clacktronics/5150uvc/docs/5150UVC_schematic.pdf

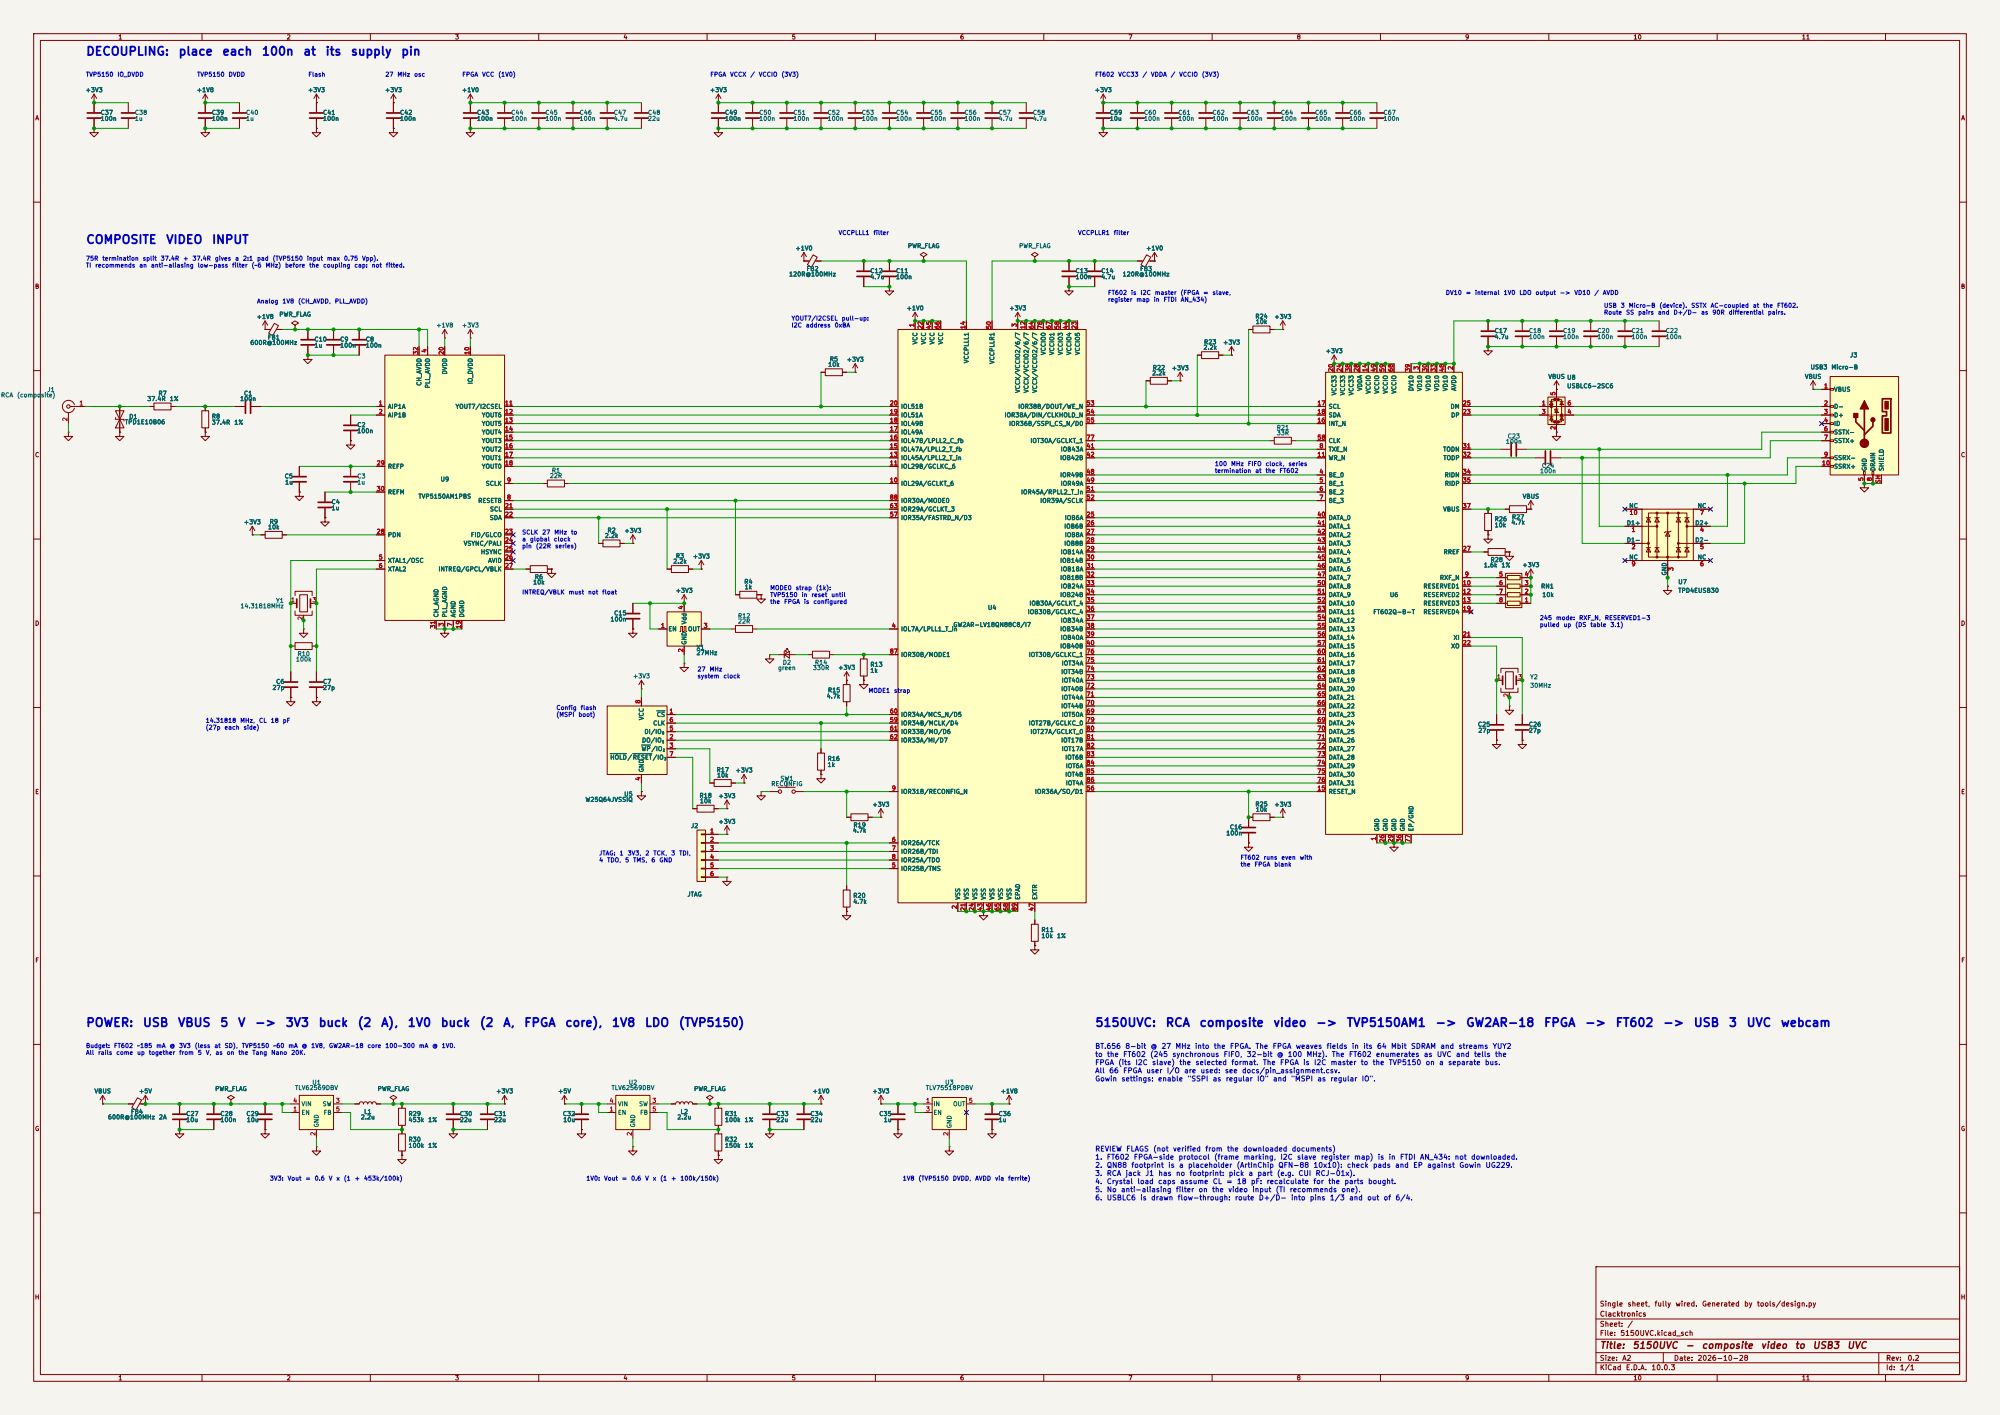
[picture p1: page 1]

75R termination split 37.4R + 37.4R gives a 2:1 pad (TVP5150 input max 0.75 Vpp). TI recommends an anti-aliasing low-pass filter (~6 MHz) before the coupling cap: not fitted. DECOUPLING: place each 100n at its supply pin

INTREQ/VBLK must not float COMPOSITE VIDEO INPUT

FT602 is I2C master (FPGA = slave,

DV10 = internal 1V0 LDO output -> VD10 / AVDD

VBUS VBUS SSRX-SSRX-SSRX+ SSRX+

termination at the FT602 | 100n R27

a global clock pin (22R series)

9 RESERVED1 9 RESERVED1 6 6 | 3 3

MODE0 strap (1k): TVP5150 in reset until the FPGA is configured

245 mode: RXF_N, RESERVED1-3
pulled up (DS table 3.1)

4 DI/IO0 5 CLK 6 HOLD/RESET/IO3 7 VCC

JTAG: 1 3V3, 2 TCK, 3 TDI, 4 TDO, 5 TMS, 6 GND

3 3 | IOR26B/TDI 7
4 4 | IOR25A/TDO 8
5 5 | IOR25B/TMS 5

the FPGA blank Budget: FT602 ~185 mA @ 3V3 (less at SD), TVP5150 ~60 mA @ 1V8, GW2AR-18 core 100-300 mA @ 1V0. All rails come up together from 5 V, as on the Tang Nano 20K. POWER: USB VBUS 5 V -> 3V3 buck (2 A), 1V0 buck (2 A, FPGA core), 1V8 LDO (TVP5150)

5150UVC: RCA composite video -> TVP5150AM1 -> GW2AR-18 FPGA -> FT602 -> USB 3 UVC webcam

BT.656 8-bit @ 27 MHz into the FPGA. The FPGA weaves fields in its 64 Mbit SDRAM and streams YUY2
to the FT602 (245 synchronous FIFO, 32-bit @ 100 MHz). The FT602 enumerates as UVC and tells the
FPGA (its I2C slave) the selected format. The FPGA is I2C master to the TVP5150 on a separate bus.
All 66 FPGA user I/O are used: see docs/pin_assignment.csv.
Gowin settings: enable "SSPI as regular IO" and "MSPI as regular IO".

REVIEW FLAGS (not verified from the downloaded documents)
1. FT602 FPGA-side protocol (frame marking, I2C slave register map) is in FTDI AN_434: not downloaded.
2. QN88 footprint is a placeholder (ArtInChip QFN-88 10x10): check pads and EP against Gowin UG229.
3. RCA jack J1 has no footprint: pick a part (e.g. CUI RCJ-01x).
4. Crystal load caps assume CL = 18 pF: recalculate for the parts bought.
5. No anti-aliasing filter on the video input (TI recommends one).
6. USBLC6 is drawn flow-through: route D+/D- into pins 1/3 and out of 6/4.

1V8 (TVP5150 DVDD, AVDD via ferrite)

Single sheet, fully wired. Generated by tools/design.py
Clacktronics
Sheet: /
File: 5150UVC.kicad_sch
Title: 5150UVC - composite video to USB3 UVC

Size: A2 | Rev: 0.2
KiCad E.D.A. 10.0.3 | Id: 1/1
