clacktronics/5150uvc/hardware/5150UVC.kicad_sch

## KiCad design hardware/5150UVC.kicad_sch (2026-11-06)

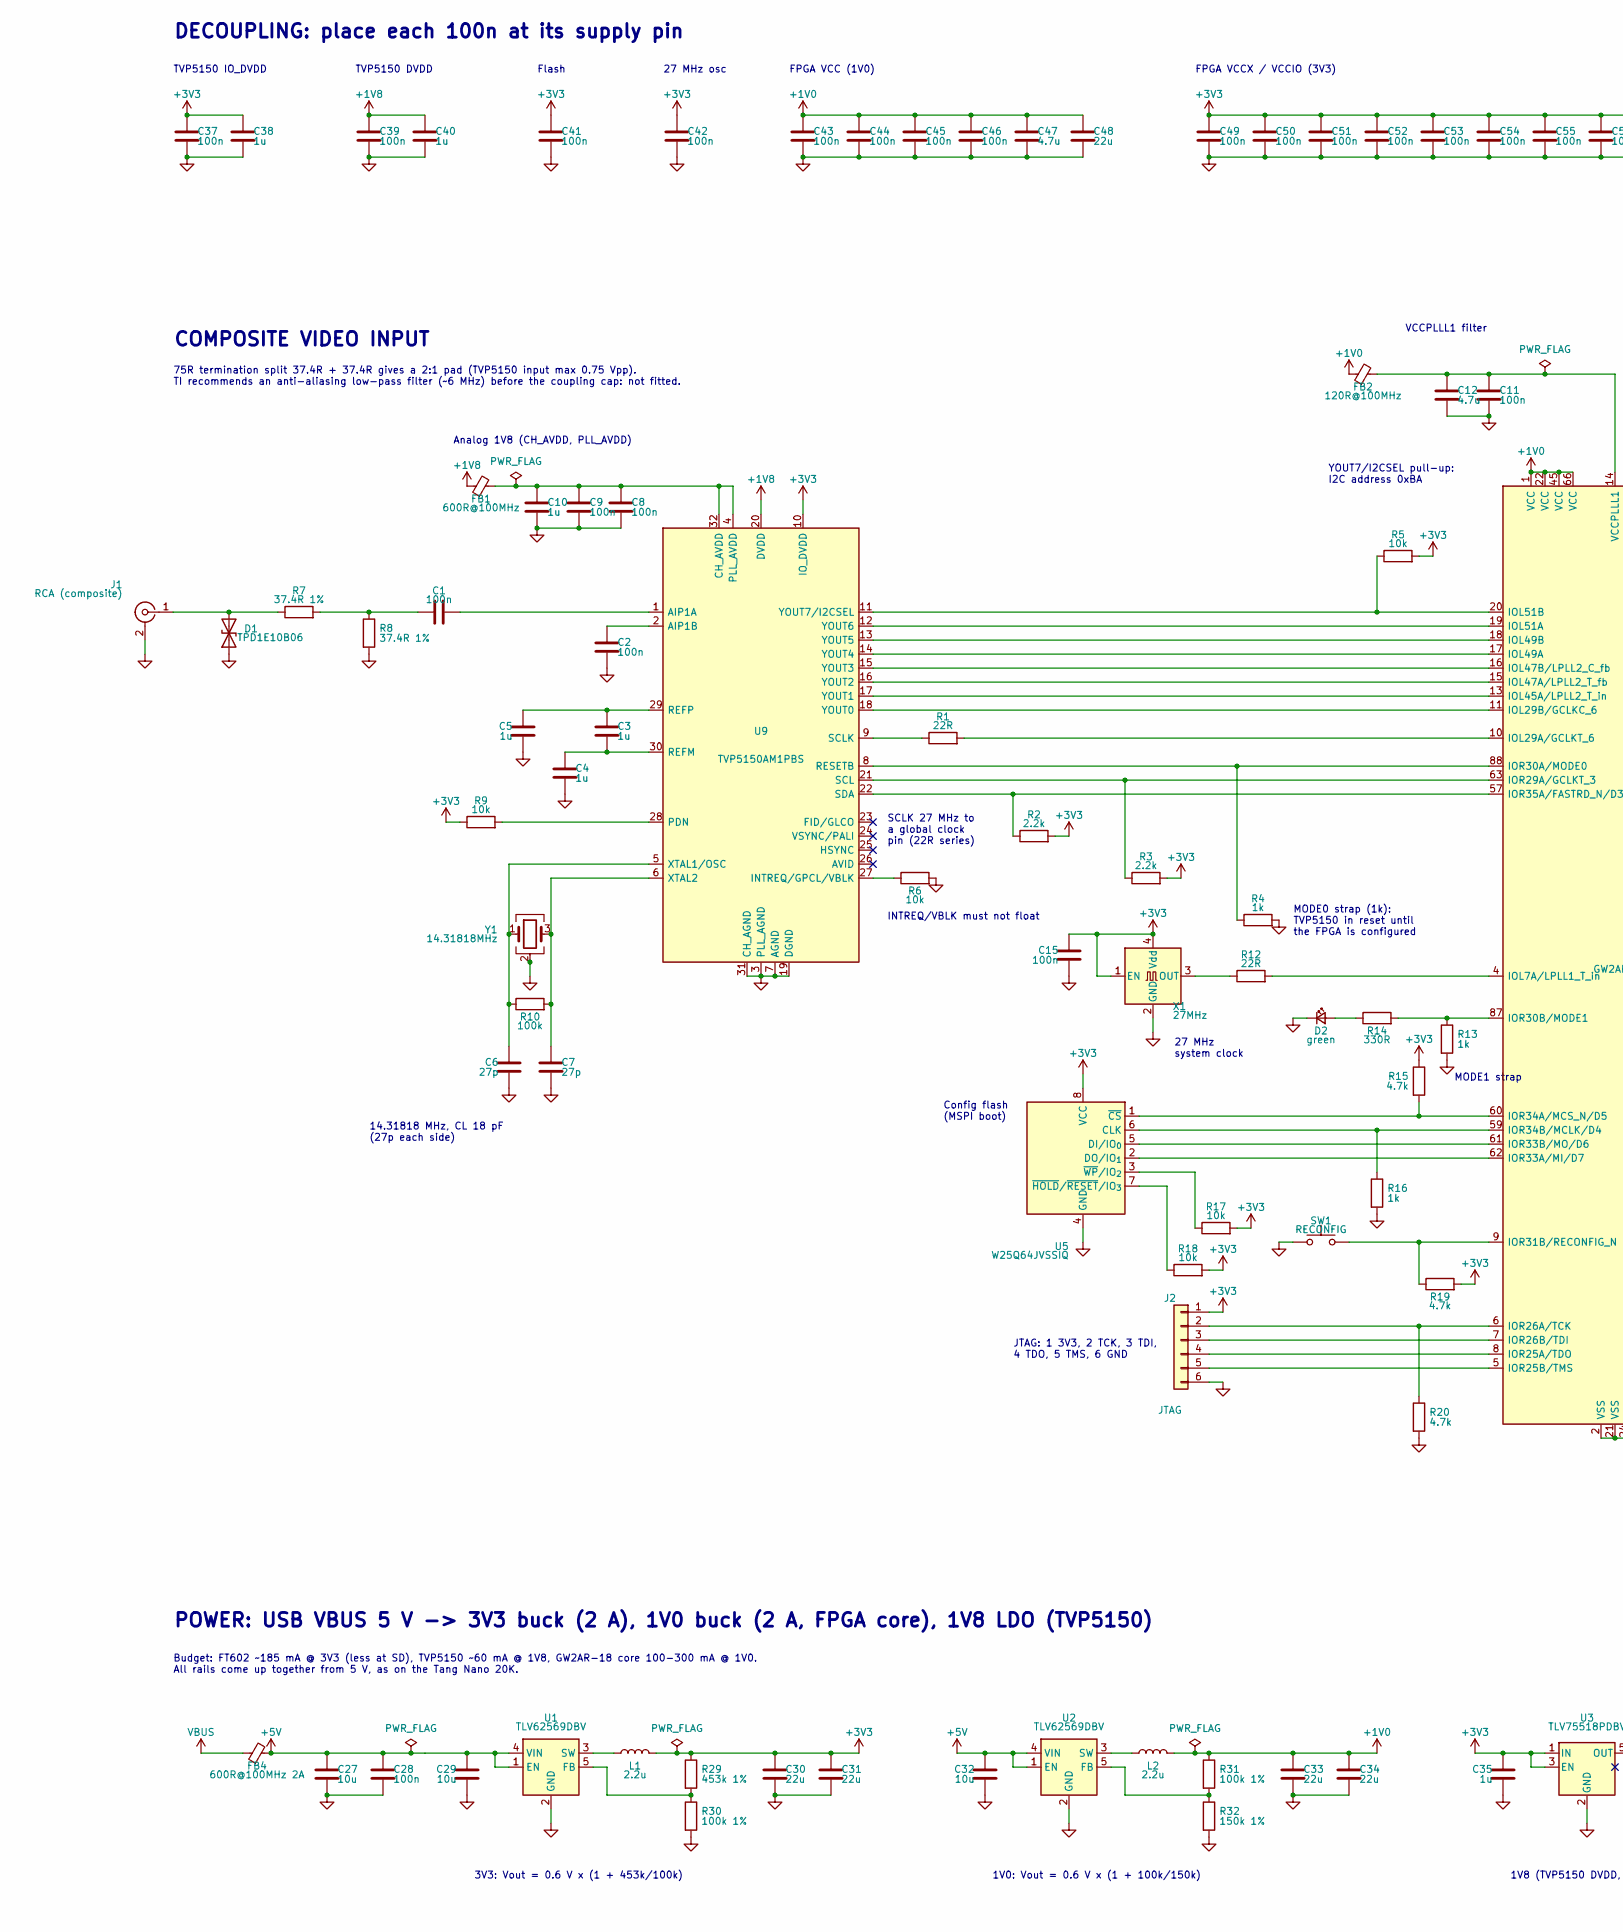
[picture p2: schematic 5150UVC.kicad_sch, part in row 1, column 1]

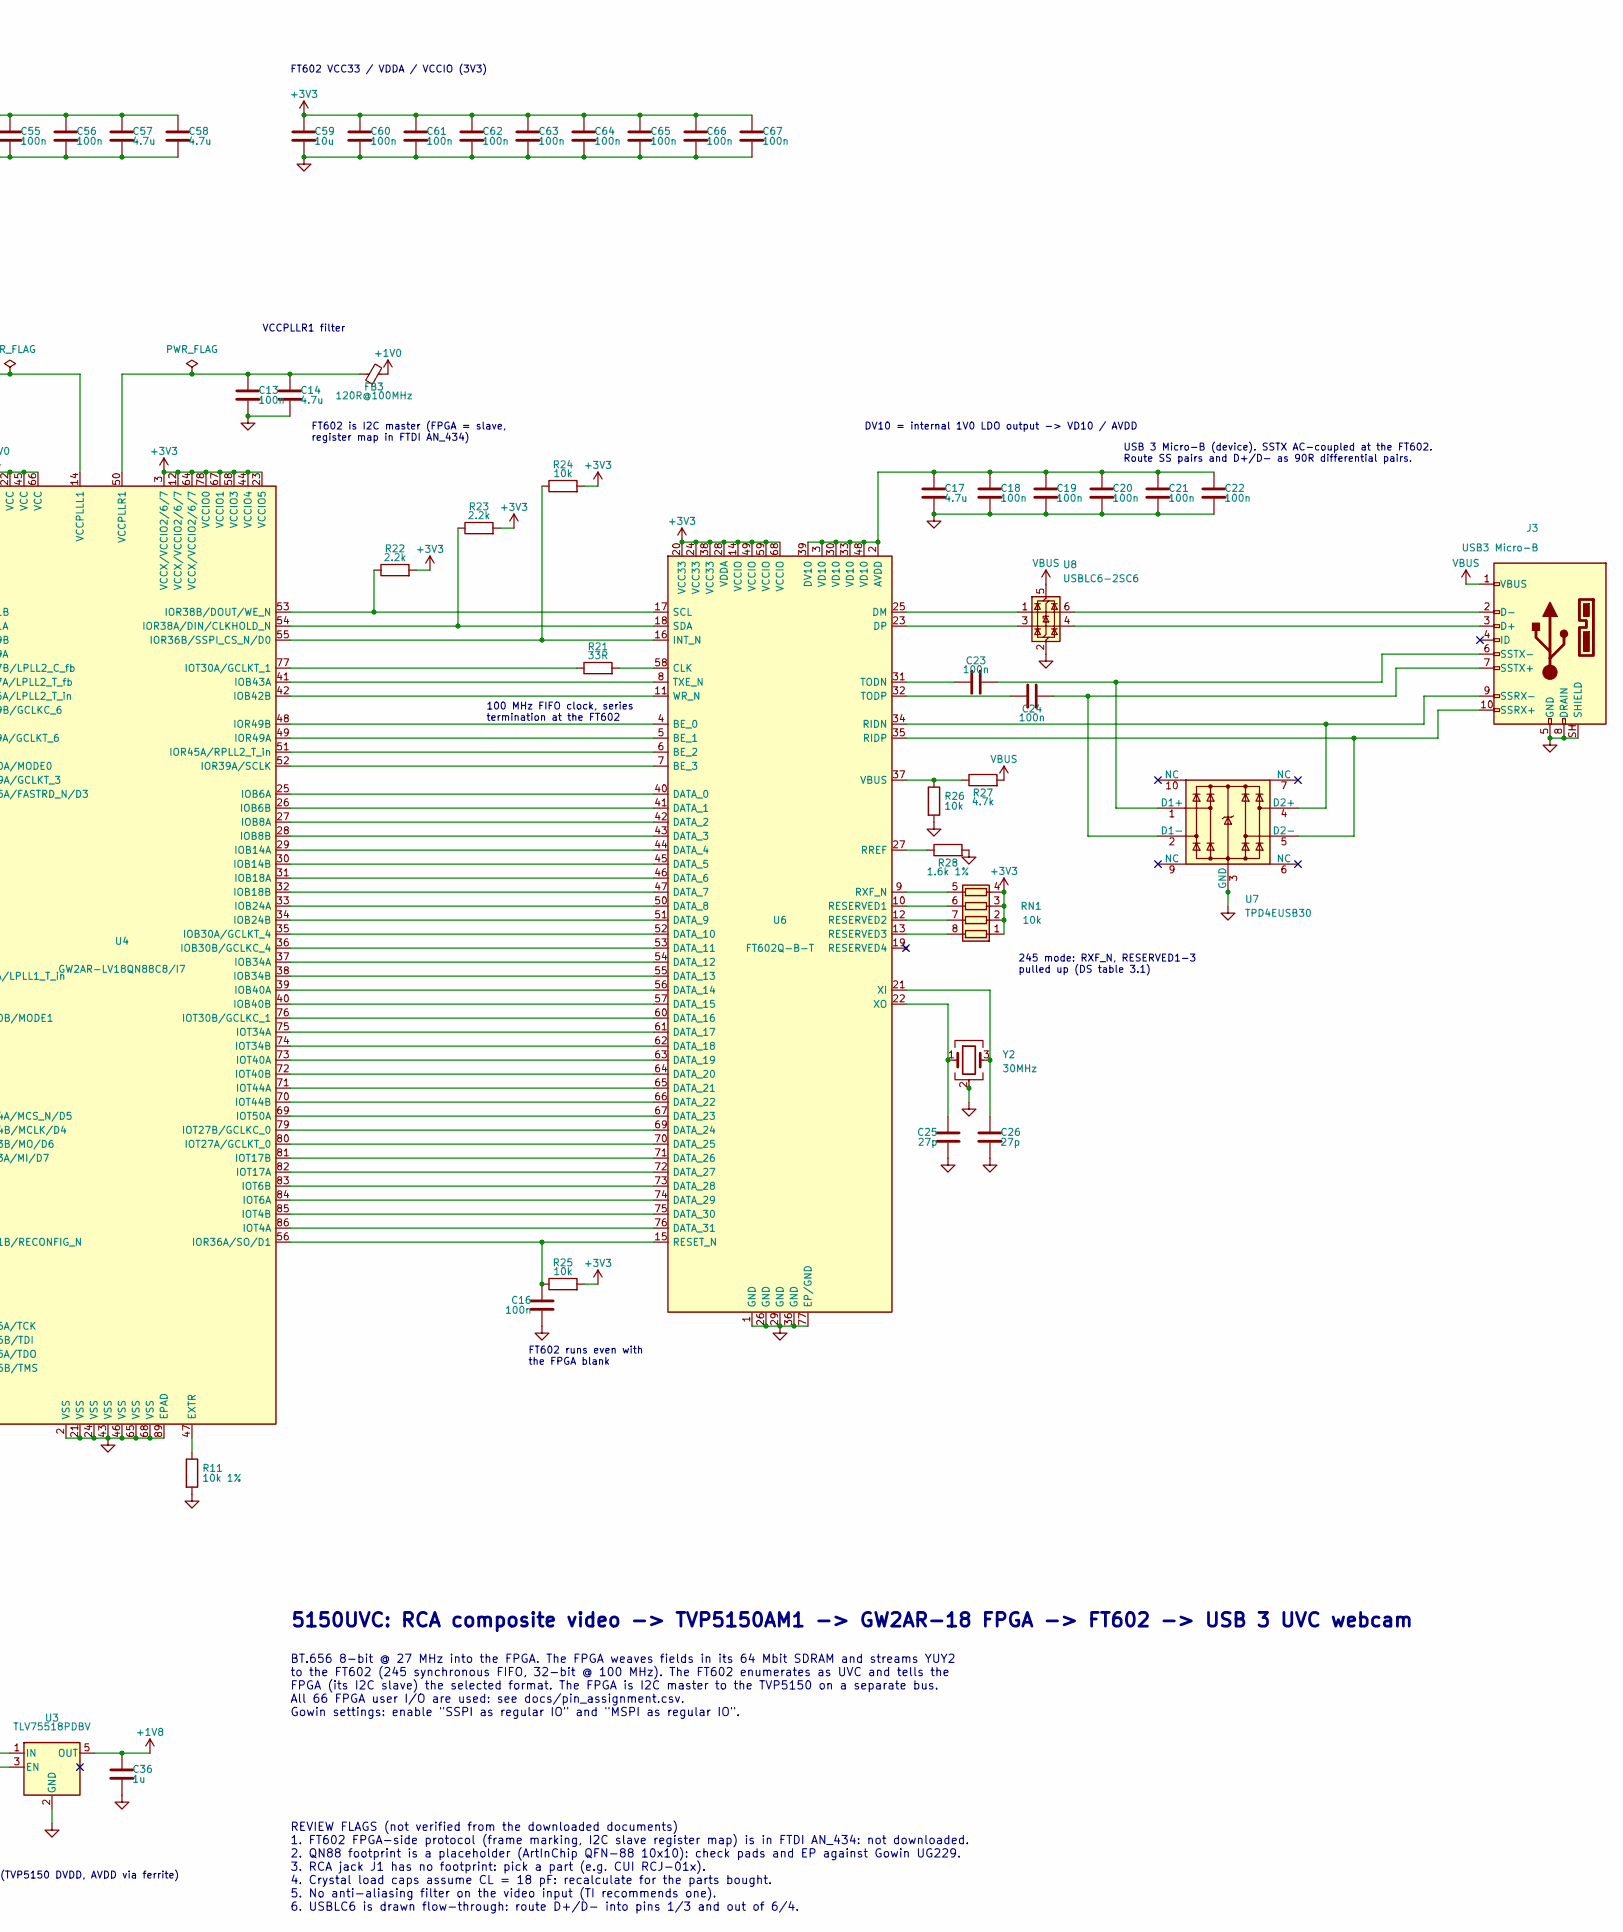
[picture p3: schematic 5150UVC.kicad_sch, part in row 1, column 2]

Parts:
C1, C2, C8, C9, C11, C13, C15, C16, C18, C19, C20, C21, C22, C23, C24, C28, C37, C39, C41, C42, C43, C44, C45, C46, C49, C50, C51, C52, C53, C54, C55, C56, C60, C61, C62, C63, C64, C65, C66, C67: 100n; C_0402_1005Metric
C3, C4, C5, C10, C35, C36, C38, C40: 1u; C_0603_1608Metric
C6, C7, C25, C26: 27p; C_0402_1005Metric
C12, C14, C17, C47, C57, C58: 4.7u; C_0603_1608Metric
C27, C29, C32, C59: 10u; C_0805_2012Metric
C30, C31, C33, C34, C48: 22u; C_0805_2012Metric
D1: TPD1E10B06; D_0402_1005Metric
D2: green; LED_0603_1608Metric
FB1: 600R@100MHz; L_0603_1608Metric
FB2, FB3: 120R@100MHz; L_0603_1608Metric
FB4: 600R@100MHz 2A; L_0603_1608Metric
J1: RCA (composite)
J2: JTAG; PinHeader_1x06_P2.54mm_Vertical
J3: USB3 Micro-B; USB3_Micro-B_Connfly_DS1104-01
L1, L2: 2.2u; L_1008_2520Metric
R1, R12: 22R; R_0402_1005Metric
R2, R3, R22, R23: 2.2k; R_0402_1005Metric
R4, R13, R16: 1k; R_0402_1005Metric
R5, R6, R9, R17, R18, R24, R25, R26: 10k; R_0402_1005Metric
R7, R8: 37.4R 1%; R_0402_1005Metric
R10: 100k; R_0402_1005Metric
R11: 10k 1%; R_0402_1005Metric
R14: 330R; R_0402_1005Metric
R15, R19, R20, R27: 4.7k; R_0402_1005Metric
R21: 33R; R_0402_1005Metric
R28: 1.6k 1%; R_0402_1005Metric
R29: 453k 1%; R_0402_1005Metric
R30, R31: 100k 1%; R_0402_1005Metric
R32: 150k 1%; R_0402_1005Metric
RN1: 10k; R_Array_Convex_4x0402
SW1: RECONFIG; SW_SPST_TL3342
U1, U2: TLV62569DBV; SOT-23-5
U3: TLV75518PDBV; SOT-23-5
U4: GW2AR-LV18QN88C8/I7; ArtInChip_QFN-88-1EP_10x10mm_P0.4mm_EP6.74x6.74mm
U5: W25Q64JVSSIQ; SOIC-8_5.3x5.3mm_P1.27mm
U6: FT602Q-B-T; QFN-76-1EP_9x9mm_P0.4mm_EP5.81x6.31mm
U7: TPD4EUSB30; USON-10_2.5x1.0mm_P0.5mm
U8: USBLC6-2SC6; SOT-23-6
U9: TVP5150AM1PBS; TQFP-32_7x7mm_P0.8mm
X1: 27MHz; Oscillator_SMD_Abracon_ASE-4Pin_3.2x2.5mm
Y1: 14.31818MHz; Crystal_SMD_3225-4Pin_3.2x2.5mm
Y2: 30MHz; Crystal_SMD_3225-4Pin_3.2x2.5mm

Connections:
+1V0: C33.1, C34.1, C43.1, C44.1, C45.1, C46.1, C47.1, C48.1, FB2.1, FB3.2, L2.2, R31.1, U4.1 (VCC), U4.22 (VCC), U4.45 (VCC), U4.66 (VCC)
+1V8: C36.1, C39.1, C40.1, FB1.1, U3.5 (OUT), U9.20 (DVDD)
+3V3: C15.1, C30.1, C31.1, C35.1, C37.1, C38.1, C41.1, C42.1, C49.1, C50.1, C51.1, C52.1, C53.1, C54.1, C55.1, C56.1, C57.1, C58.1, C59.1, C60.1, C61.1, C62.1, C63.1, C64.1, C65.1, C66.1, C67.1, J2.1, L1.2, R2.2, R3.2, R5.2, R9.1, R15.1, R17.2, R18.2, R19.2, R22.2, R23.2, R24.2, R25.2, R29.1, RN1.1 (R1.1), RN1.2 (R2.1), RN1.3 (R3.1), RN1.4 (R4.1), U3.1 (IN), U3.3 (EN), U4.3 (VCCX/VCCIO2/6/7), U4.12 (VCCX/VCCIO2/6/7), U4.23 (VCCIO5), U4.44 (VCCIO4), U4.58 (VCCIO3), U4.64 (VCCX/VCCIO2/6/7), U4.67 (VCCIO1), U4.78 (VCCIO0), U5.8 (VCC), U6.14 (VCCIO), U6.20 (VCC33), U6.24 (VCC33), U6.28 (VDDA), U6.38 (VCC33), U6.49 (VCCIO), U6.59 (VCCIO), U6.68 (VCCIO), U9.10 (IO_DVDD), X1.1 (EN), X1.4 (Vdd)
+5V: C27.1, C28.1, C29.1, C32.1, FB4.2, U1.1 (EN), U1.4 (VIN), U2.1 (EN), U2.4 (VIN)
GND: C2.2, C4.2, C5.2, C6.2, C7.2, C8.2, C9.2, C10.2, C11.2, C12.2, C13.2, C14.2, C15.2, C16.2, C17.2, C18.2, C19.2, C20.2, C21.2, C22.2, C25.2, C26.2, C27.2, C28.2, C29.2, C30.2, C31.2, C32.2, C33.2, C34.2, C35.2, C36.2, C37.2, C38.2, C39.2, C40.2, C41.2, C42.2, C43.2, C44.2, C45.2, C46.2, C47.2, C48.2, C49.2, C50.2, C51.2, C52.2, C53.2, C54.2, C55.2, C56.2, C57.2, C58.2, C59.2, C60.2, C61.2, C62.2, C63.2, C64.2, C65.2, C66.2, C67.2, D1.1 (A1), D2.1 (K), J1.2 (Ext), J2.6, J3.5 (GND), J3.8 (DRAIN), J3.SH (SHIELD), R4.2, R6.2, R8.2, R11.2, R13.2, R16.2, R20.2, R26.2, R28.2, R30.2, R32.2, SW1.1, U1.2 (GND), U2.2 (GND), U3.2 (GND), U4.2 (VSS), U4.21 (VSS), U4.24 (VSS), U4.43 (VSS), U4.46 (VSS), U4.65 (VSS), U4.68 (VSS), U4.89 (EPAD), U5.4 (GND), U6.1 (GND), U6.26 (GND), U6.29 (GND), U6.36 (GND), U6.77 (EP/GND), U7.3 (GND), U7.8 (GND), U8.2 (GND), U9.3 (PLL_AGND), U9.7 (AGND), U9.19 (DGND), U9.31 (CH_AGND), X1.2 (GND), Y1.2 (G), Y1.4 (G), Y2.2 (G), Y2.4 (G)
unnamed: C1.1, R7.2, R8.1
unnamed: C1.2, U9.1 (AIP1A)
unnamed: C2.1, U9.2 (AIP1B)
unnamed: C3.1, C5.1, U9.29 (REFP)
unnamed: C3.2, C4.1, U9.30 (REFM)
unnamed: C6.1, R10.1, U9.5 (XTAL1/OSC), Y1.1
unnamed: C7.1, R10.2, U9.6 (XTAL2), Y1.3
unnamed: C8.1, C9.1, C10.1, FB1.2, U9.4 (PLL_AVDD), U9.32 (CH_AVDD)
unnamed: C11.1, C12.1, FB2.2, U4.14 (VCCPLLL1)
unnamed: C13.1, C14.1, FB3.1, U4.50 (VCCPLLR1)
unnamed: C16.1, R25.1, U4.56 (IOR36A/SO/D1), U6.15 (RESET_N)
unnamed: C17.1, C18.1, C19.1, C20.1, C21.1, C22.1, U6.2 (AVDD), U6.3 (VD10), U6.30 (VD10), U6.33 (VD10), U6.39 (DV10), U6.48 (VD10)
unnamed: C23.1, U6.31 (TODN)
unnamed: C23.2, J3.6 (SSTX-), U7.1 (D1+)
unnamed: C24.1, U6.32 (TODP)
unnamed: C24.2, J3.7 (SSTX+), U7.2 (D1-)
unnamed: C25.1, U6.22 (XO), Y2.1
unnamed: C26.1, U6.21 (XI), Y2.3
unnamed: D1.2 (A2), J1.1 (In), R7.1
unnamed: D2.2 (A), R14.1
unnamed: J2.2, R20.1, U4.6 (IOR26A/TCK)
unnamed: J2.3, U4.7 (IOR26B/TDI)
unnamed: J2.4, U4.8 (IOR25A/TDO)
unnamed: J2.5, U4.5 (IOR25B/TMS)
unnamed: J3.2 (D-), U8.6 (I/O1)
unnamed: J3.3 (D+), U8.4 (I/O2)
unnamed: J3.9 (SSRX-), U6.34 (RIDN), U7.4 (D2+)
unnamed: J3.10 (SSRX+), U6.35 (RIDP), U7.5 (D2-)
unnamed: L1.1, U1.3 (SW)
unnamed: L2.1, U2.3 (SW)
unnamed: R1.1, U9.9 (SCLK)
unnamed: R1.2, U4.10 (IOL29A/GCLKT_6)
unnamed: R2.1, U4.57 (IOR35A/FASTRD_N/D3), U9.22 (SDA)
unnamed: R3.1, U4.63 (IOR29A/GCLKT_3), U9.21 (SCL)
unnamed: R4.1, U4.88 (IOR30A/MODE0), U9.8 (RESETB)
unnamed: R5.1, U4.20 (IOL51B), U9.11 (YOUT7/I2CSEL)
unnamed: R6.1, U9.27 (INTREQ/GPCL/VBLK)
unnamed: R9.2, U9.28 (PDN)
unnamed: R11.1, U4.47 (EXTR)
unnamed: R12.1, X1.3 (OUT)
unnamed: R12.2, U4.4 (IOL7A/LPLL1_T_in)
unnamed: R13.1, R14.2, U4.87 (IOR30B/MODE1)
unnamed: R15.2, U4.60 (IOR34A/MCS_N/D5), U5.1 (~CS)
unnamed: R16.1, U4.59 (IOR34B/MCLK/D4), U5.6 (CLK)
unnamed: R17.1, U5.3 (~WP/IO_{2})
unnamed: R18.1, U5.7 (~HOLD/~RESET/IO_{3})
unnamed: R19.1, SW1.2, U4.9 (IOR31B/RECONFIG_N)
unnamed: R21.1, U4.77 (IOT30A/GCLKT_1)
unnamed: R21.2, U6.58 (CLK)
unnamed: R22.1, U4.53 (IOR38B/DOUT/WE_N), U6.17 (SCL)
unnamed: R23.1, U4.54 (IOR38A/DIN/CLKHOLD_N), U6.18 (SDA)
unnamed: R24.1, U4.55 (IOR36B/SSPI_CS_N/D0), U6.16 (INT_N)
unnamed: R26.1, R27.1, U6.37 (VBUS)
unnamed: R28.1, U6.27 (RREF)
unnamed: R29.2, R30.1, U1.5 (FB)
unnamed: R31.2, R32.1, U2.5 (FB)
unnamed: RN1.5 (R4.2), U6.9 (RXF_N)
unnamed: RN1.6 (R3.2), U6.10 (RESERVED1)
unnamed: RN1.7 (R2.2), U6.12 (RESERVED2)
unnamed: RN1.8 (R1.2), U6.13 (RESERVED3)
unnamed: U4.11 (IOL29B/GCLKC_6), U9.18 (YOUT0)
unnamed: U4.13 (IOL45A/LPLL2_T_in), U9.17 (YOUT1)
unnamed: U4.15 (IOL47A/LPLL2_T_fb), U9.16 (YOUT2)
unnamed: U4.16 (IOL47B/LPLL2_C_fb), U9.15 (YOUT3)
unnamed: U4.17 (IOL49A), U9.14 (YOUT4)
unnamed: U4.18 (IOL49B), U9.13 (YOUT5)
unnamed: U4.19 (IOL51A), U9.12 (YOUT6)
unnamed: U4.25 (IOB6A), U6.40 (DATA_0)
unnamed: U4.26 (IOB6B), U6.41 (DATA_1)
unnamed: U4.27 (IOB8A), U6.42 (DATA_2)
unnamed: U4.28 (IOB8B), U6.43 (DATA_3)
unnamed: U4.29 (IOB14A), U6.44 (DATA_4)
unnamed: U4.30 (IOB14B), U6.45 (DATA_5)
unnamed: U4.31 (IOB18A), U6.46 (DATA_6)
unnamed: U4.32 (IOB18B), U6.47 (DATA_7)
unnamed: U4.33 (IOB24A), U6.50 (DATA_8)
unnamed: U4.34 (IOB24B), U6.51 (DATA_9)
unnamed: U4.35 (IOB30A/GCLKT_4), U6.52 (DATA_10)
unnamed: U4.36 (IOB30B/GCLKC_4), U6.53 (DATA_11)
unnamed: U4.37 (IOB34A), U6.54 (DATA_12)
unnamed: U4.38 (IOB34B), U6.55 (DATA_13)
unnamed: U4.39 (IOB40A), U6.56 (DATA_14)
unnamed: U4.40 (IOB40B), U6.57 (DATA_15)
unnamed: U4.41 (IOB43A), U6.8 (TXE_N)
unnamed: U4.42 (IOB42B), U6.11 (WR_N)
unnamed: U4.48 (IOR49B), U6.4 (BE_0)
unnamed: U4.49 (IOR49A), U6.5 (BE_1)
unnamed: U4.51 (IOR45A/RPLL2_T_in), U6.6 (BE_2)
unnamed: U4.52 (IOR39A/SCLK), U6.7 (BE_3)
unnamed: U4.61 (IOR33B/MO/D6), U5.5 (DI/IO_{0})
unnamed: U4.62 (IOR33A/MI/D7), U5.2 (DO/IO_{1})
unnamed: U4.69 (IOT50A), U6.67 (DATA_23)
unnamed: U4.70 (IOT44B), U6.66 (DATA_22)
unnamed: U4.71 (IOT44A), U6.65 (DATA_21)
unnamed: U4.72 (IOT40B), U6.64 (DATA_20)
unnamed: U4.73 (IOT40A), U6.63 (DATA_19)
unnamed: U4.74 (IOT34B), U6.62 (DATA_18)
unnamed: U4.75 (IOT34A), U6.61 (DATA_17)
unnamed: U4.76 (IOT30B/GCLKC_1), U6.60 (DATA_16)
unnamed: U4.79 (IOT27B/GCLKC_0), U6.69 (DATA_24)
unnamed: U4.80 (IOT27A/GCLKT_0), U6.70 (DATA_25)
unnamed: U4.81 (IOT17B), U6.71 (DATA_26)
unnamed: U4.82 (IOT17A), U6.72 (DATA_27)
unnamed: U4.83 (IOT6B), U6.73 (DATA_28)
unnamed: U4.84 (IOT6A), U6.74 (DATA_29)
unnamed: U4.85 (IOT4B), U6.75 (DATA_30)
unnamed: U4.86 (IOT4A), U6.76 (DATA_31)
unnamed: U6.23 (DP), U8.3 (I/O2)
unnamed: U6.25 (DM), U8.1 (I/O1)
VBUS: FB4.1, J3.1 (VBUS), R27.2, U8.5 (VBUS)

Notes on the sheet:
YOUT7/I2CSEL pull-up: I2C address 0xBA
MODE0 strap (1k): TVP5150 in reset until the FPGA is configured
INTREQ/VBLK must not float
SCLK 27 MHz to a global clock pin (22R series)
COMPOSITE VIDEO INPUT
75R termination split 37.4R + 37.4R gives a 2:1 pad (TVP5150 input max 0.75 Vpp). TI recommends an anti-aliasing low-pass filter (~6 MHz) before the coupling cap: not fitted.
14.31818 MHz, CL 18 pF (27p each side)
Analog 1V8 (CH_AVDD, PLL_AVDD)
VCCPLLL1 filter
VCCPLLR1 filter
27 MHz system clock
MODE1 strap
Config flash (MSPI boot)
JTAG: 1 3V3, 2 TCK, 3 TDI, 4 TDO, 5 TMS, 6 GND
FT602 is I2C master (FPGA = slave, register map in FTDI AN_434)
100 MHz FIFO clock, series termination at the FT602
FT602 runs even with the FPGA blank
DV10 = internal 1V0 LDO output -> VD10 / AVDD
USB 3 Micro-B (device). SSTX AC-coupled at the FT602. Route SS pairs and D+/D- as 90R differential pairs.
245 mode: RXF_N, RESERVED1-3 pulled up (DS table 3.1)
POWER: USB VBUS 5 V -> 3V3 buck (2 A), 1V0 buck (2 A, FPGA core), 1V8 LDO (TVP5150)
Budget: FT602 ~185 mA @ 3V3 (less at SD), TVP5150 ~60 mA @ 1V8, GW2AR-18 core 100-300 mA @ 1V0. All rails come up together from 5 V, as on the Tang Nano 20K.
3V3: Vout = 0.6 V x (1 + 453k/100k)
1V0: Vout = 0.6 V x (1 + 100k/150k)
1V8 (TVP5150 DVDD, AVDD via ferrite)
DECOUPLING: place each 100n at its supply pin
TVP5150 IO_DVDD
TVP5150 DVDD
Flash
27 MHz osc
FPGA VCC (1V0)
FPGA VCCX / VCCIO (3V3)
FT602 VCC33 / VDDA / VCCIO (3V3)
5150UVC: RCA composite video -> TVP5150AM1 -> GW2AR-18 FPGA -> FT602 -> USB 3 UVC webcam
BT.656 8-bit @ 27 MHz into the FPGA. The FPGA weaves fields in its 64 Mbit SDRAM and streams YUY2 to the FT602 (245 synchronous FIFO, 32-bit @ 100 MHz). The FT602 enumerates as UVC and tells the FPGA (its I2C slave) the selected format. The FPGA is I2C master to the TVP5150 on a separate bus. All 6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
REVIEW FLAGS (not verified from the downloaded documents) 1. FT602 FPGA-side protocol (frame marking, I2C slave register map) is in FTDI AN_434: not downloaded. 2. QN88 footprint is a placeholder (ArtInChip QFN-88 10x10): check pads and EP against Gowin UG229. 3. RCA jack J1 has no footprint: pick 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
